MemoireMorte/Memo-1/how-to/Memo-1 sans minitel.pdf

## Memo-1 sans minitel

Le Memo-1 peut etre ulisé sans Minitel, bien que l’expérience soit dégradée.
Pour cela il faut créer un câble tel que présenté ci-dessous, et connecter le Memo-1 à votre PC avec un câble USB.

Le module ulisé ici est un module TTL to USB avec une puce FTDI. Il est très courant et coute environ 6€. Des modules TTL to USB avec une puce CH340 fonconneront de la même façon.

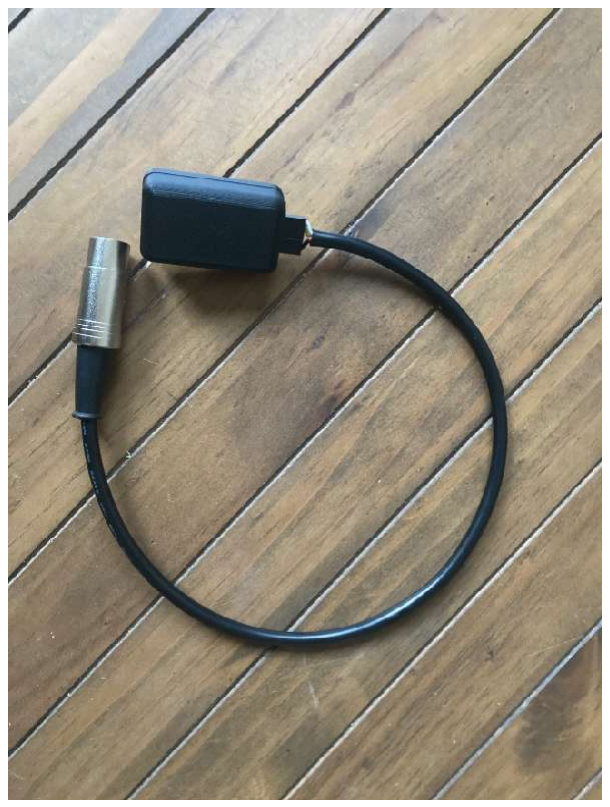
[picture p9: figure]
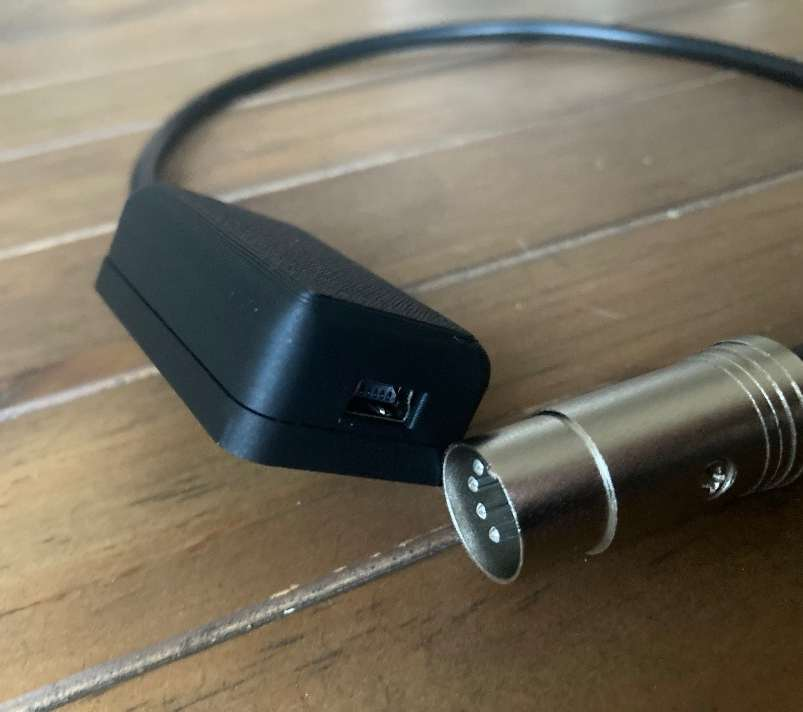
[picture p10: figure]

Le Memo-1 doit etre alimenté en externe, un module TTL to USB ne fournirait que quelques dizaines de milliampère, ce qui est trop peu pour le Memo-1.
Le RX va au TX, et vis-versa. (RX = Receive ; TX = Transmit)

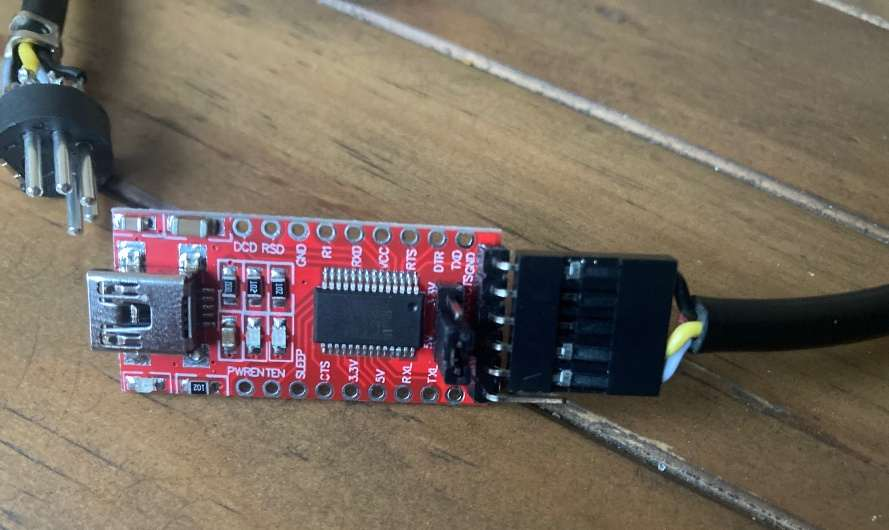
[picture p11: figure]
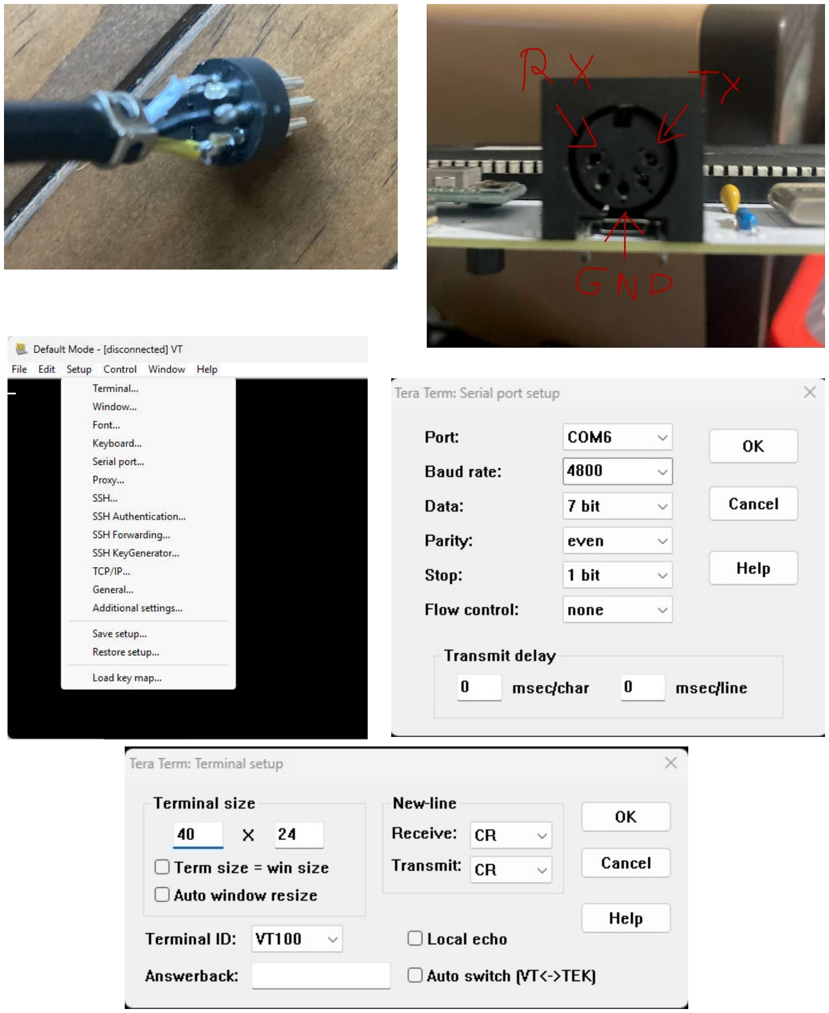
[picture p12: page 2]

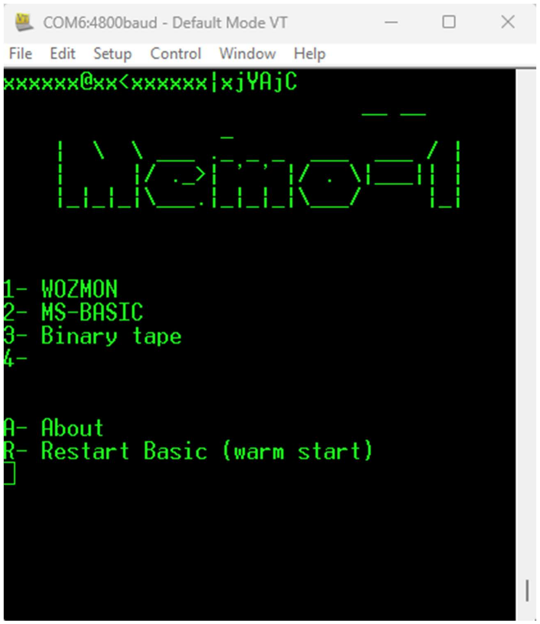
[picture p13: figure]

Des caractères incompréhensibles apparaissent de temps en temps. Il s’agit des ordres donnés au minitel ( vider l’écran, changer de vitesse, etc…) qui ne peuvent être interprétés par votre émulateur de terminal.
