MemoireMorte/Memo-1/how-to/memo-1.pdf

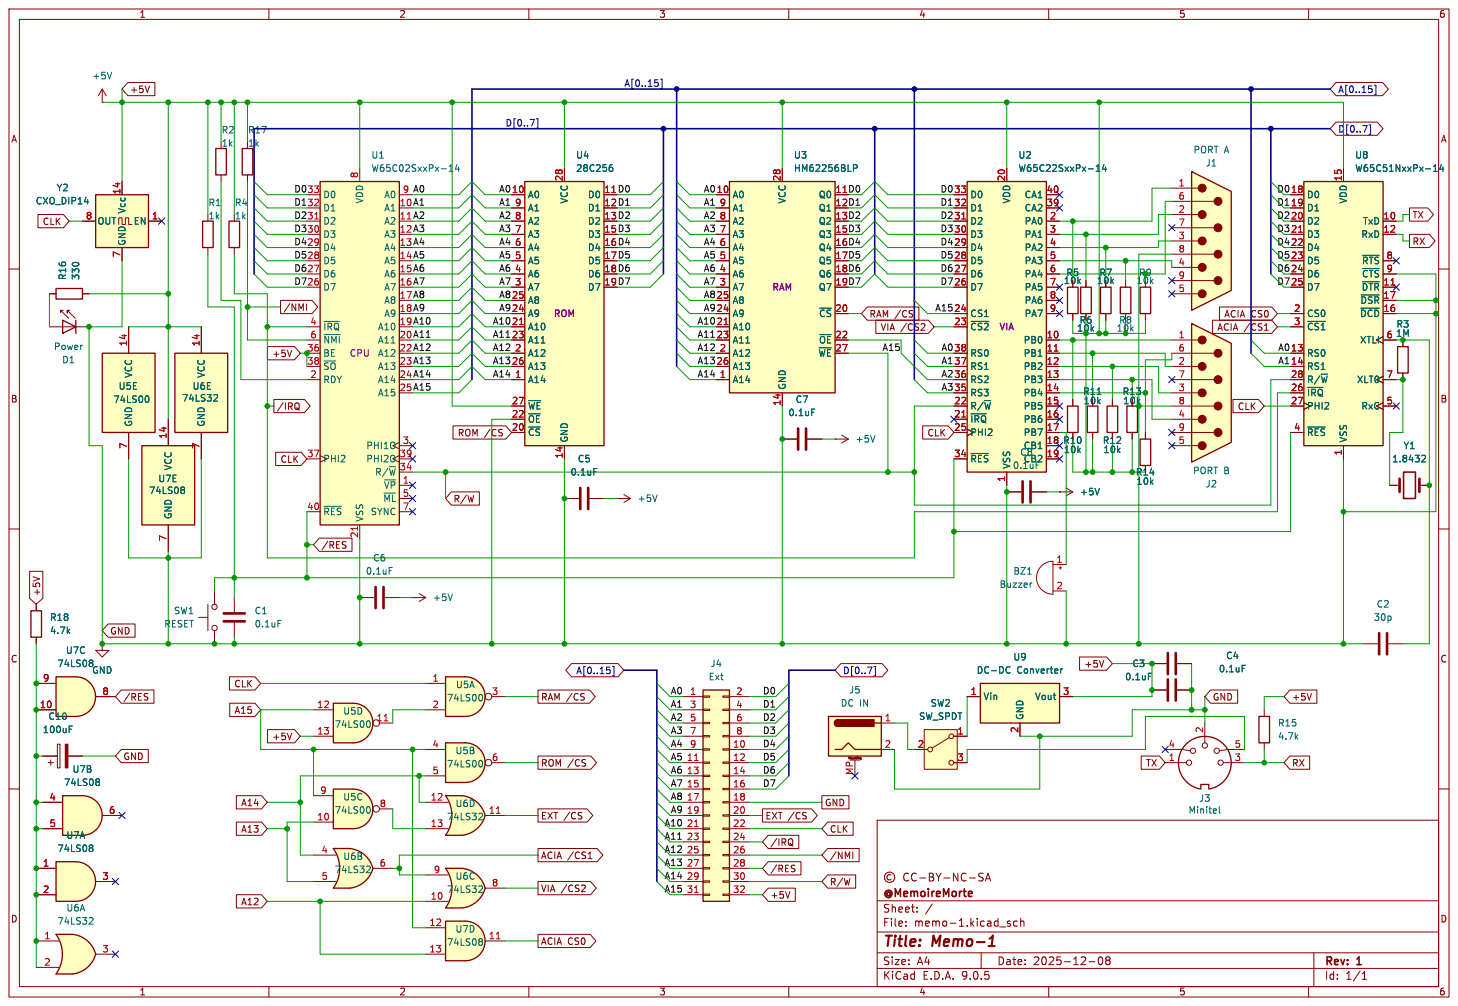
[picture p15: page 1]

1 TxD 10 RxD 12 ~{RTS}8 ~{CTS}9 ~{DTR} 11 ~{DSR} 17 ~{DCD} 16 XTLI 6 XLT0 7 RxC 5 U8 W65C51NxxPx-14 VCC 14 GND

8 VSS 21 A0 9 A1 10 A2 11 A3 12 A4 13 A5 14 A6 15 A7 16 A8 17 A9 18 A10 19 A11 20 A12 22 A13 23 A14 24 A15 25 PHI1O 3 PHI2O 39 R/~{W}34 ~{VP}1 ~{ML}5 SYNC 7 U1 W65C02SxxPx-14 CPU

1 TxD 10 RxD 12 ~{RTS}8 ~{CTS}9 ~{DTR} 11 ~{DSR} 17 ~{DCD} 16 XTLI 6 XLT0 7 RxC 5 R5

2 Vout 3 U9 DC-DC Converter R3

File: memo-1.kicad_sch Sheet: / @MemoireMorte
