MemoireMorte/Memo-1/memo-1.pdf

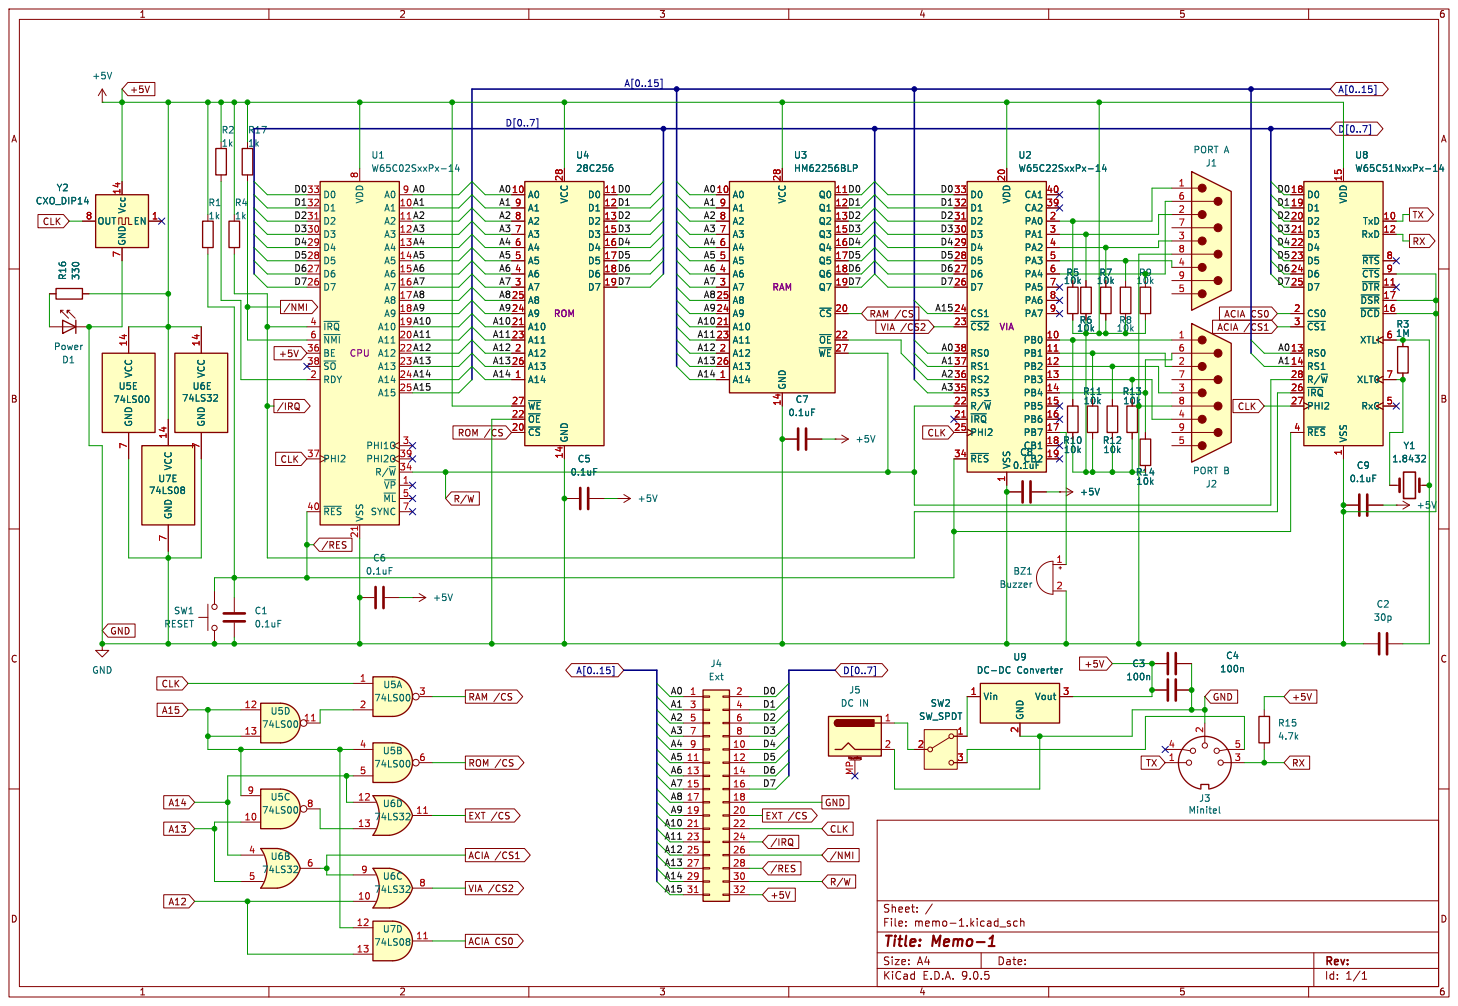
[picture p16: page 1]

1 CA1 40 CA2 39 PA0 2 PA1 3 PA2 4 PA3 5 PA4 6 PA5 7 PA6 8 PA7 9 PB0 10 PB1 11 PB2 12 PB3 13 PB4 14 PB5 15 PB6 16 PB7 17 CB1 18 CB2 19 U2 W65C22SxxPx-14 VIA R16 330 A0 10 A1 9 A2 8 A3 7 A4 6 A5 5 A6 4 A7 3 A8 25 A9 24 A10 21 A11 23 A12 2 A13 26 A14 1 ~{WE} 27 ~{OE} 22 ~{CS} 20 VCC 28 GND 14 D0 11 D1 12 D2 13 D3 15 D4 16 D5 17 D6 18 D7 19 U4

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

1 TxD 10 RxD 12 ~{RTS}8 ~{CTS}9 ~{DTR} 11 ~{DSR} 17 ~{DCD} 16 XTLI 6 XLT0 7 RxC 5 U9 DC-DC Converter Vin 1 GND

RAM /CS ROM /CS

2 Vout 3 U9 DC-DC Converter GND
