MemoireMorte/Memo-1/how-to/schematicKCS.pdf

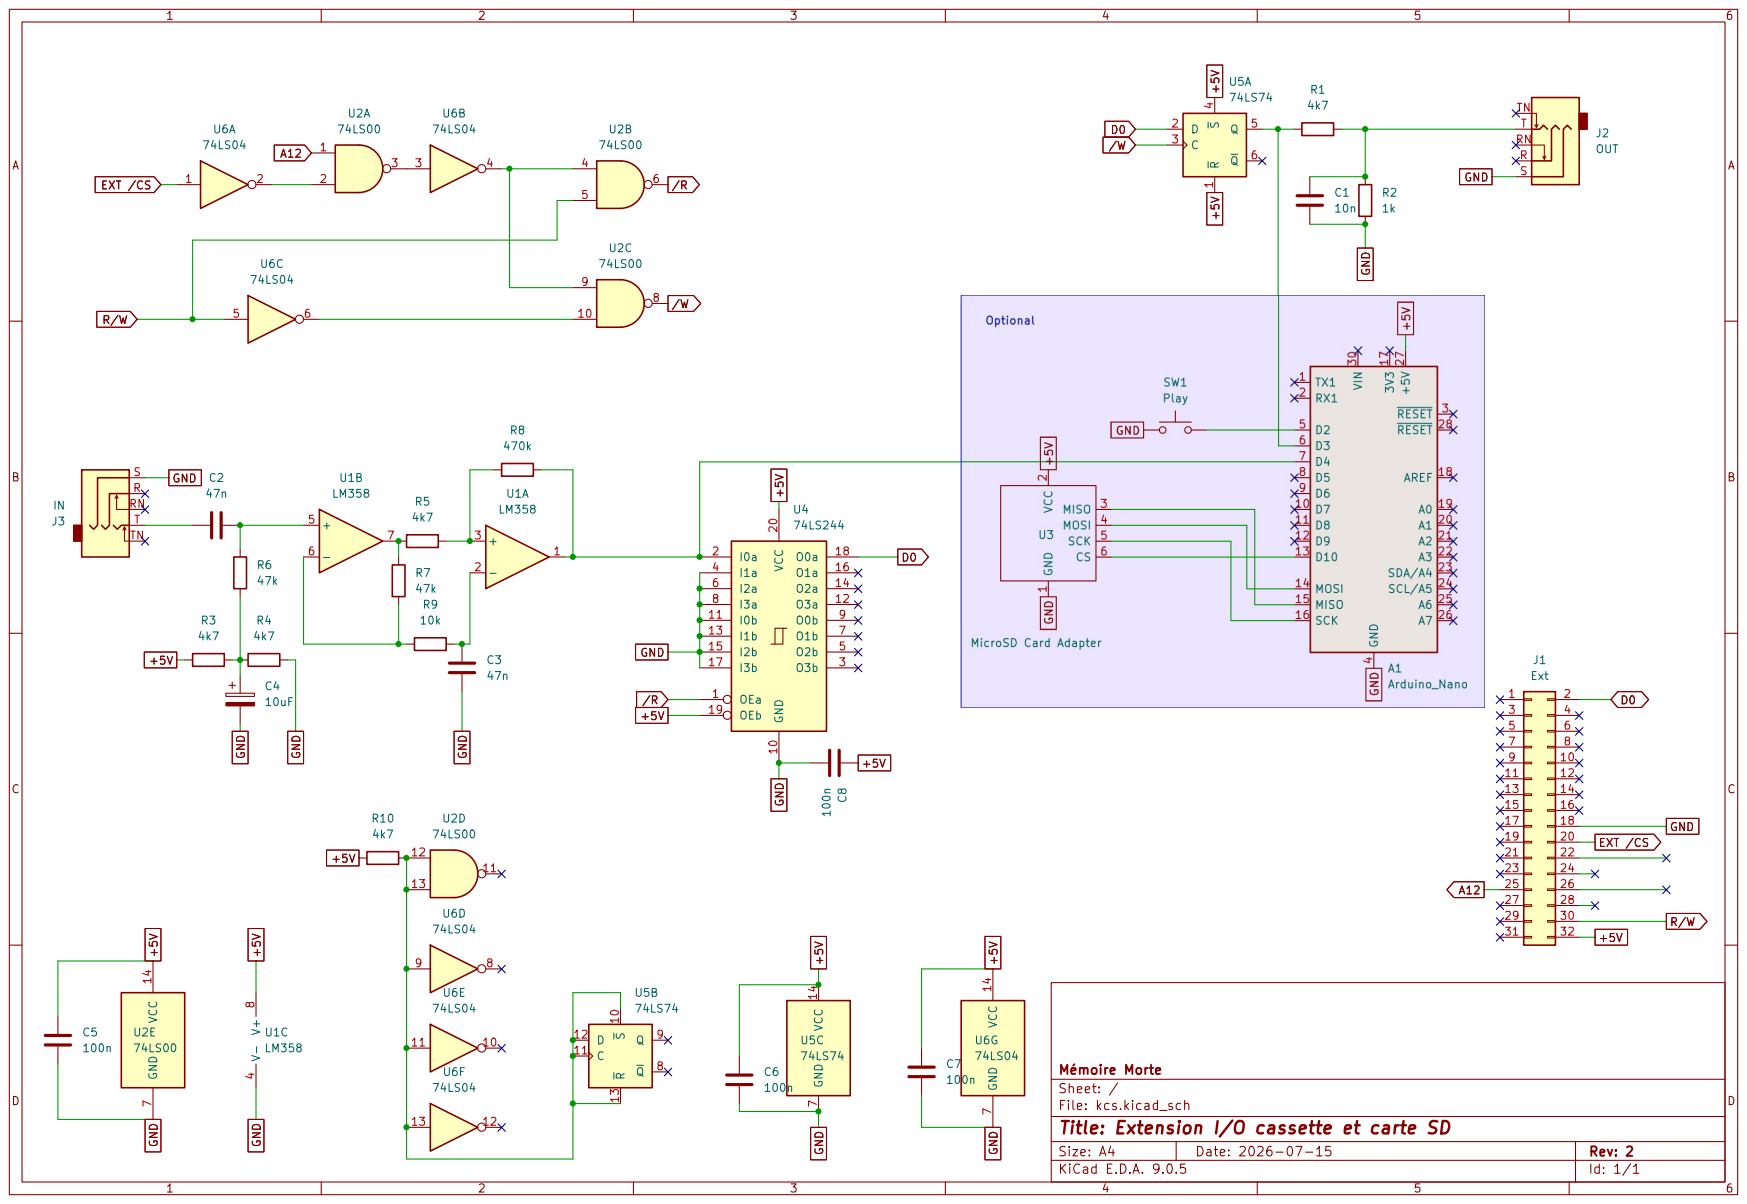
[picture p17: page 1]
