MemoireMorte/Memo-1/(commit log)

2025-10-05 add a working wip base project
    [aim65.cfg, applesoft.cfg, cbmbasic1.cfg, cbmbasic2.cfg, kb9.cfg, kbdbasic.cfg, memo.cfg, microtan.cfg]
2025-10-10 Add Minitel extended keyboard support
    [memo.cfg]
2025-10-27 Fix on schematic and start implementing minitel printer
    Schematic had pulldown resistors instead of pullups for VIA external port A and B
    Start implementing printer capability
2025-10-27 Add waiting time for printer to get ready
2025-11-27 Switch between 16k or 32k output binary
    [memo.cfg]
2025-11-30 Add BOM link to the README
2026-01-29 Add 'how to' files
    [BOM_Prototype.csv, BOM_Rev1.csv]
2026-01-29 Add link to the BOM
2026-04-01 add load logic
    [memo.cfg]
2026-05-09 mask interrupts while loading
2026-05-09 add messages and remove debug trace
2026-05-26 Add gerber files
    [kcs.csv]
2026-05-28 Arduino nano code for SD based K7 emulator
2026-05-30 fix chrout and chrin
    [memo.cfg]
2026-10-14 Rename extension KCS.pdf to schematicKCS.pdf
