MemoireMorte/Memo-1/how-to/IMG_9225.jpg

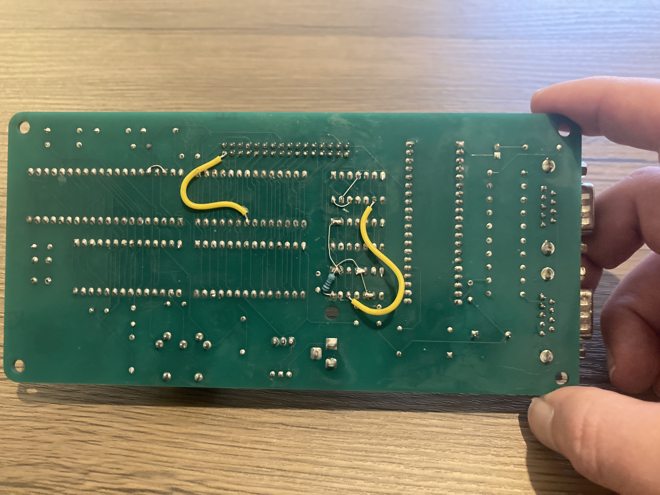
how-to/IMG_9225.jpg
